daverobertson63/RoboticsChallenge/Hardware/MicroBit/documentation/Images/L298N Board.jpg

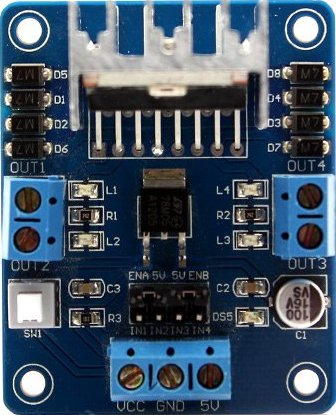
Hardware/MicroBit/documentation/Images/L298N Board.jpg
