daverobertson63/RoboticsChallenge/Hardware/MicroBit/documentation/Images/Img_0248.jpg

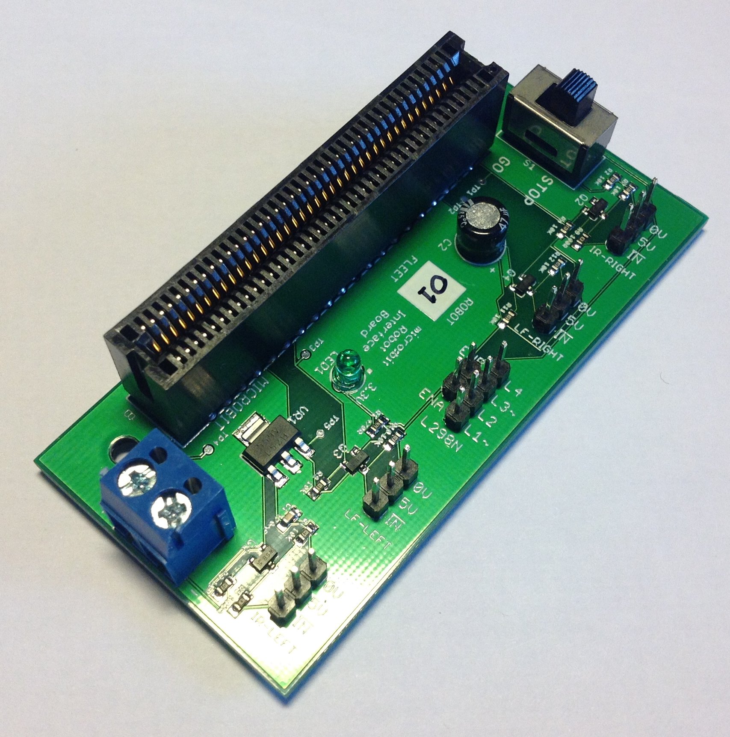
Hardware/MicroBit/documentation/Images/Img_0248.jpg
