daverobertson63/RoboticsChallenge/README.md

# RoboticsChallenge
Barclays Robotics Challenge - Main Code Repo

This is the main repo for the Barclays Remote Challenge and will work on any Unbutu style build

To install open a terminal window and make sure you are in /home/username - this is /home/roboteer

wget -N https://raw.githubusercontent.com/daverobertson63/RoboticsChallenge/master/brc.sh

chmod +x ./brc.sh

./brc.sh

Follow the instructions for either a local or remote refresh.  Local is the default one.
