daverobertson63/RoboticsChallenge/Projects/SensorProject/Sensor project.pptx

## Arduino/Pi Session

Colleague Education Series

February 2014
V1.0

Company confidential

## Build a Parking Sensor – Arduino Board

2 | Colleague Education | February 2014

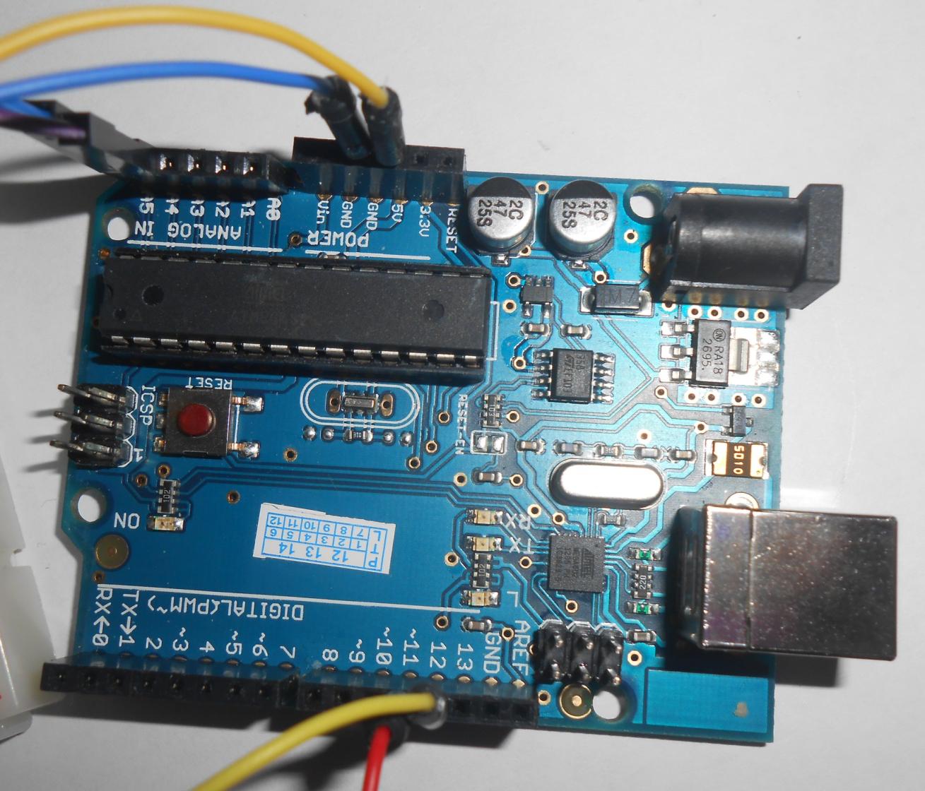
[picture p3: figure]

## Slide 3

3 | Colleague Education | February 2014

Build a Parking Sensor – Ultrasonic Sensor

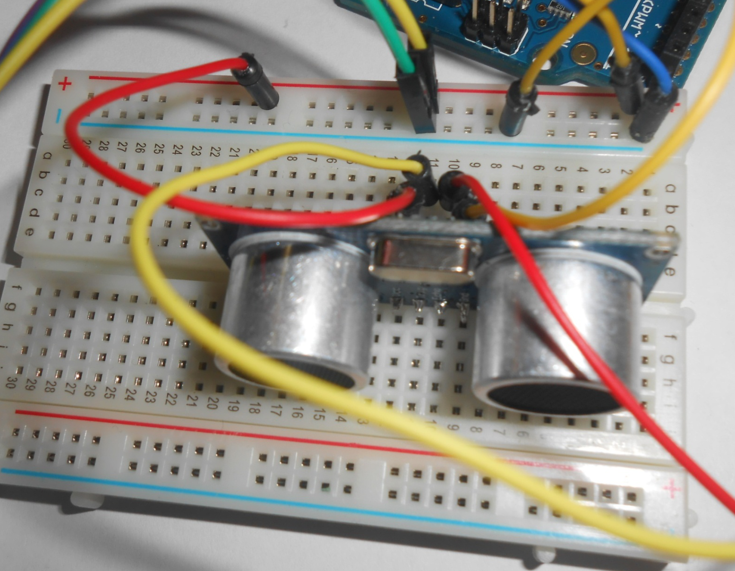
[picture p4: figure]

## Slide 4

4 | Colleague Education | February 2014

Build a Parking Sensor – LCD Screen (SainSmart)

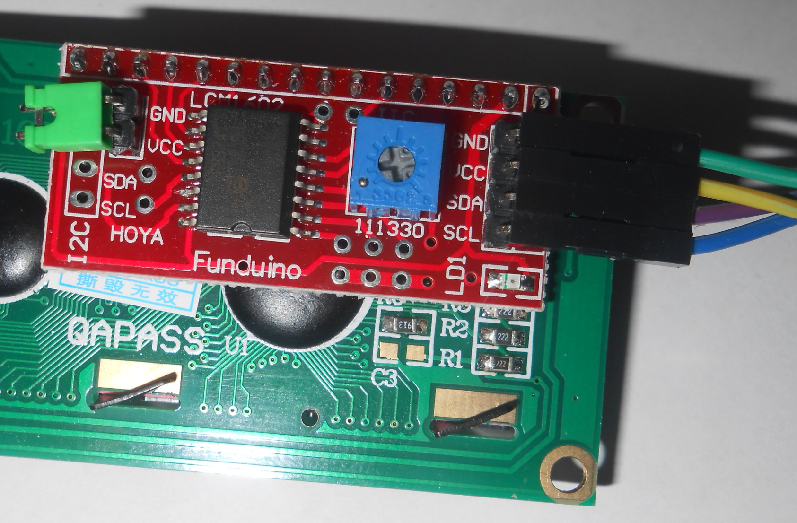
[picture p5: figure]

## Slide 5

5 | Colleague Education | February 2014

Build a Parking Sensor – LCD Screen (Digole)

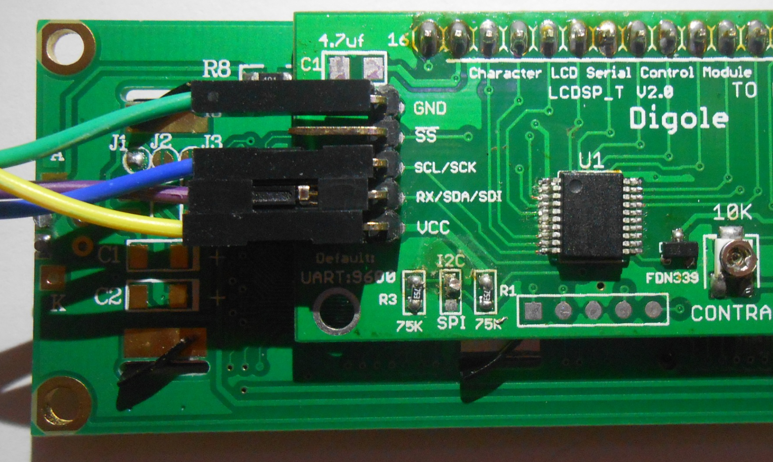
[picture p6: figure]

## Slide 6

6 | Colleague Education | February 2014

The Finished Parking Sensor

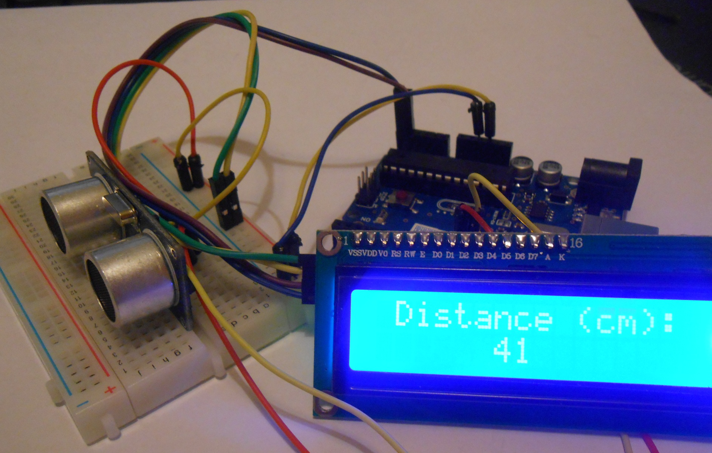
[picture p7: figure]
