daverobertson63/RoboticsChallenge/Hardware/MicroBit/documentation/Board Renders - Rev C/botcopper.png

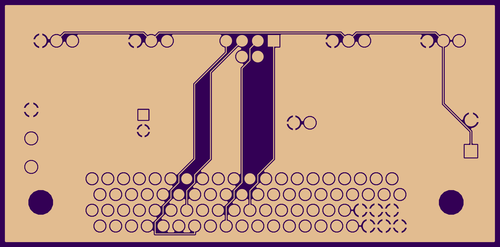
Hardware/MicroBit/documentation/Board Renders - Rev C/botcopper.png
