daverobertson63/RoboticsChallenge/Hardware/MicroBit/documentation/Board Renders - Rev C/botmask.png

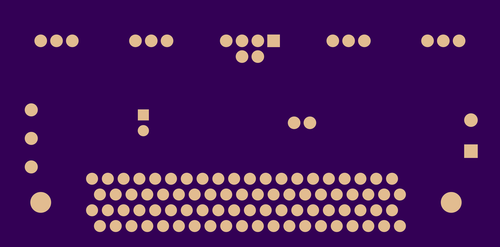
Hardware/MicroBit/documentation/Board Renders - Rev C/botmask.png
