daverobertson63/RoboticsChallenge/Hardware/MicroBit/documentation/Board Renders - Rev C/bottom.png

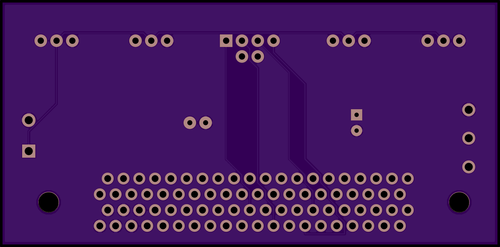
Hardware/MicroBit/documentation/Board Renders - Rev C/bottom.png
