daverobertson63/RoboticsChallenge/Hardware/MicroBit/documentation/Board Renders - Rev C/outline.png

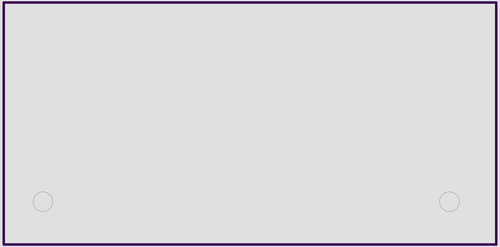
Hardware/MicroBit/documentation/Board Renders - Rev C/outline.png
