daverobertson63/RoboticsChallenge/Hardware/MicroBit/documentation/Board Renders - Rev C/top.png

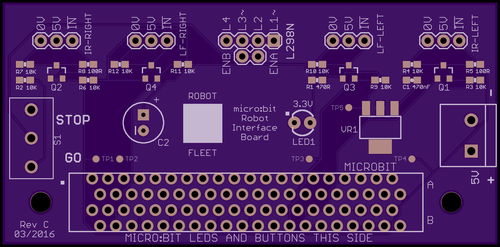
Hardware/MicroBit/documentation/Board Renders - Rev C/top.png
