daverobertson63/RoboticsChallenge/Hardware/MicroBit/documentation/Board Renders - Rev C/topcopper.png

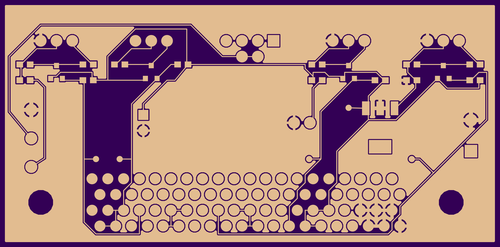
Hardware/MicroBit/documentation/Board Renders - Rev C/topcopper.png
