daverobertson63/RoboticsChallenge/Hardware/MicroBit/documentation/Board Renders - Rev C/topmask.png

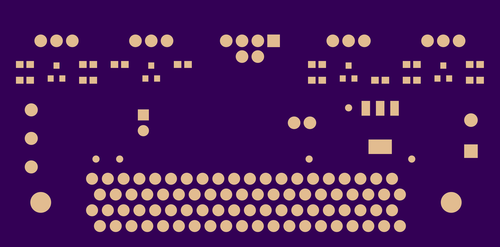
Hardware/MicroBit/documentation/Board Renders - Rev C/topmask.png
