daverobertson63/RoboticsChallenge/Hardware/MicroBit/documentation/Board Renders - Rev C/topsilk.png

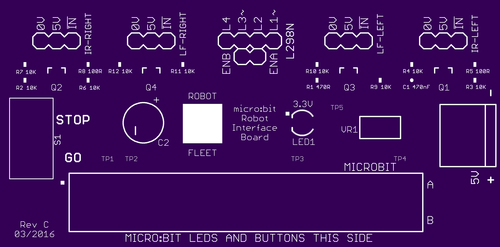
Hardware/MicroBit/documentation/Board Renders - Rev C/topsilk.png
