daverobertson63/RoboticsChallenge/Hardware/MicroBit/documentation/Images/Img_0249.jpg

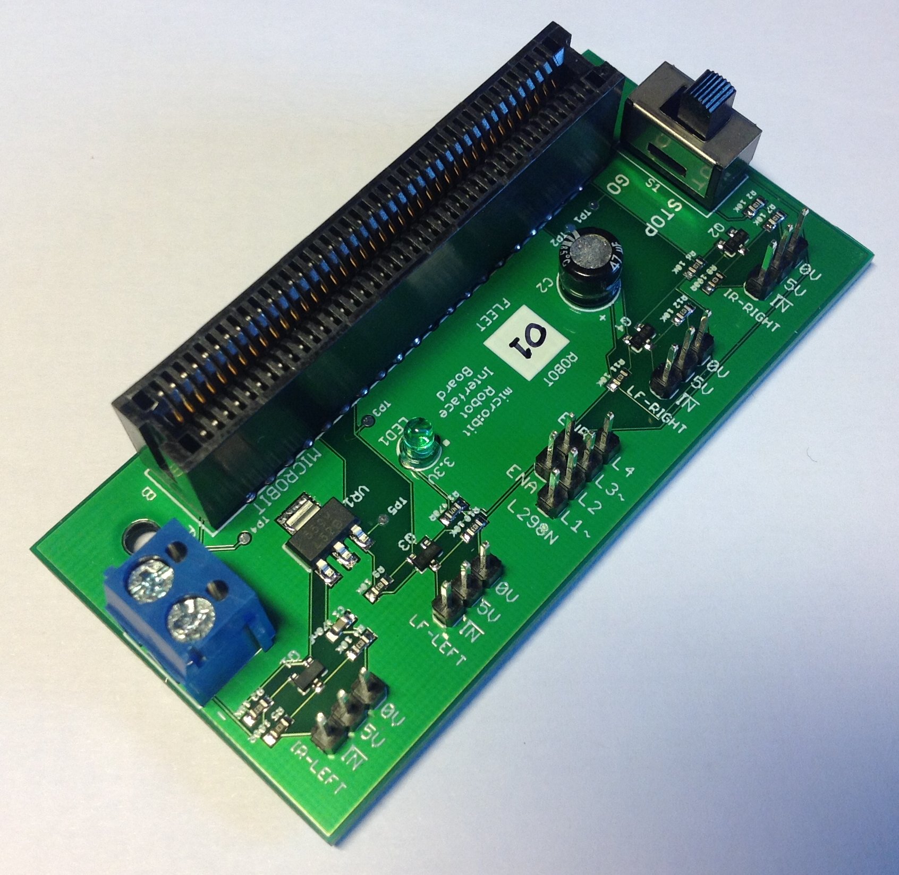
Hardware/MicroBit/documentation/Images/Img_0249.jpg
