daverobertson63/RoboticsChallenge/Hardware/MicroBit/documentation/Images/Img_0250.jpg

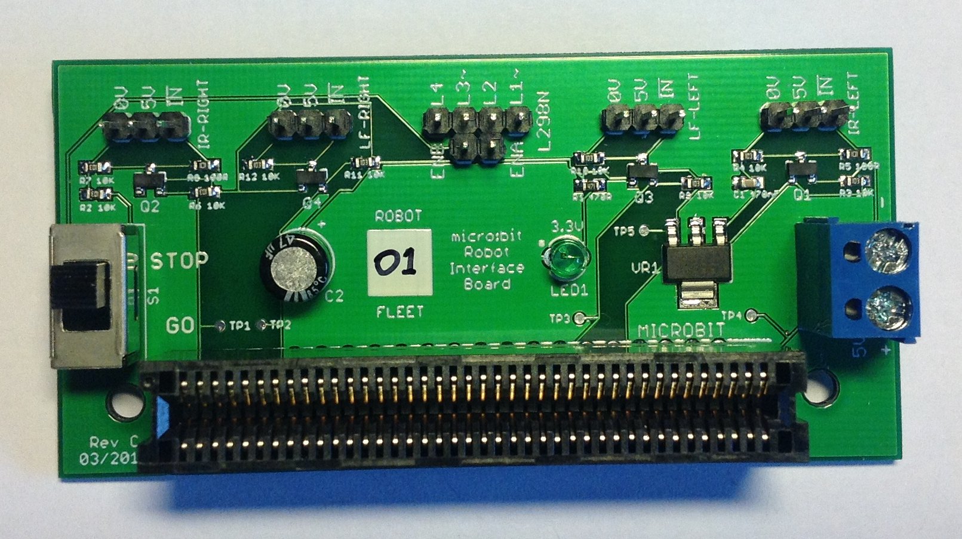
Hardware/MicroBit/documentation/Images/Img_0250.jpg
