daverobertson63/RoboticsChallenge/Hardware/MicroBit/documentation/Images/Img_0251.jpg

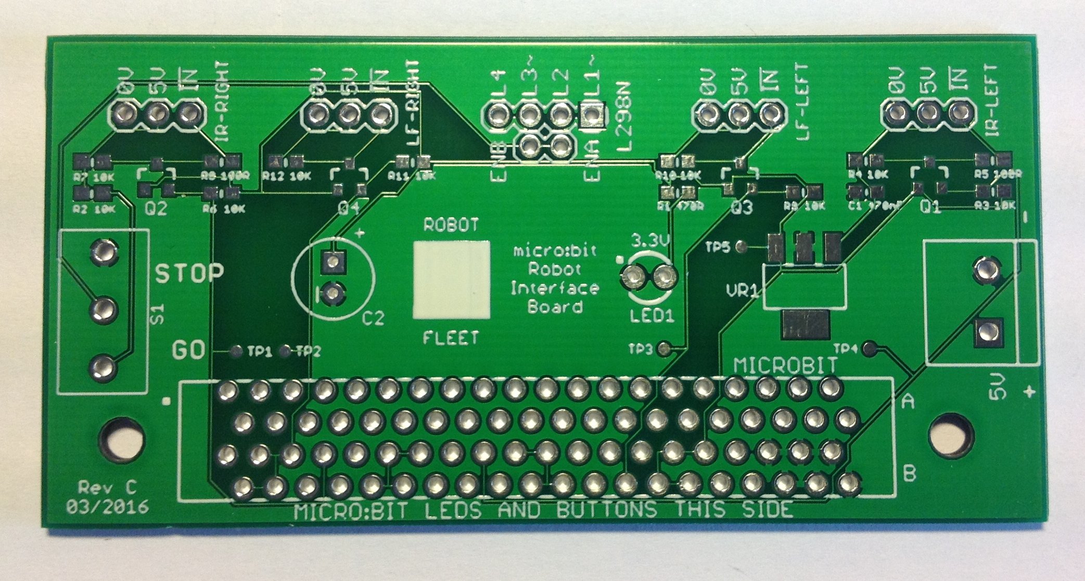
Hardware/MicroBit/documentation/Images/Img_0251.jpg
