daverobertson63/RoboticsChallenge/Hardware/MicroBit/documentation/Images/Img_0252.jpg

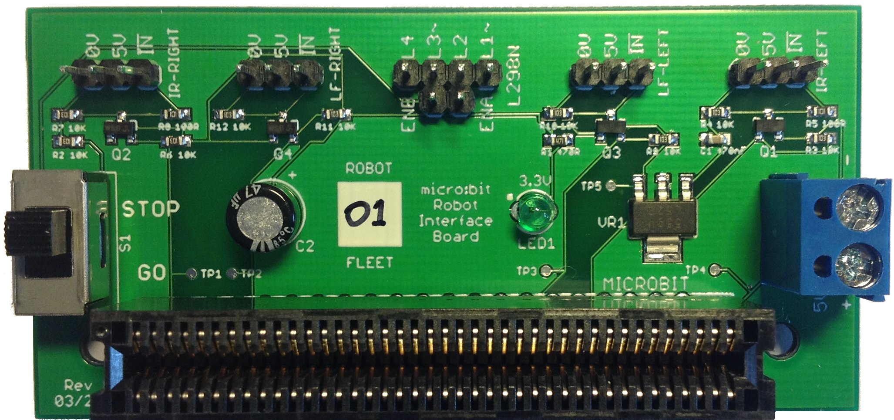
Hardware/MicroBit/documentation/Images/Img_0252.jpg
