daverobertson63/RoboticsChallenge/Hardware/MicroBit/documentation/MicroBit Robot Interface RevC - Board.pdf

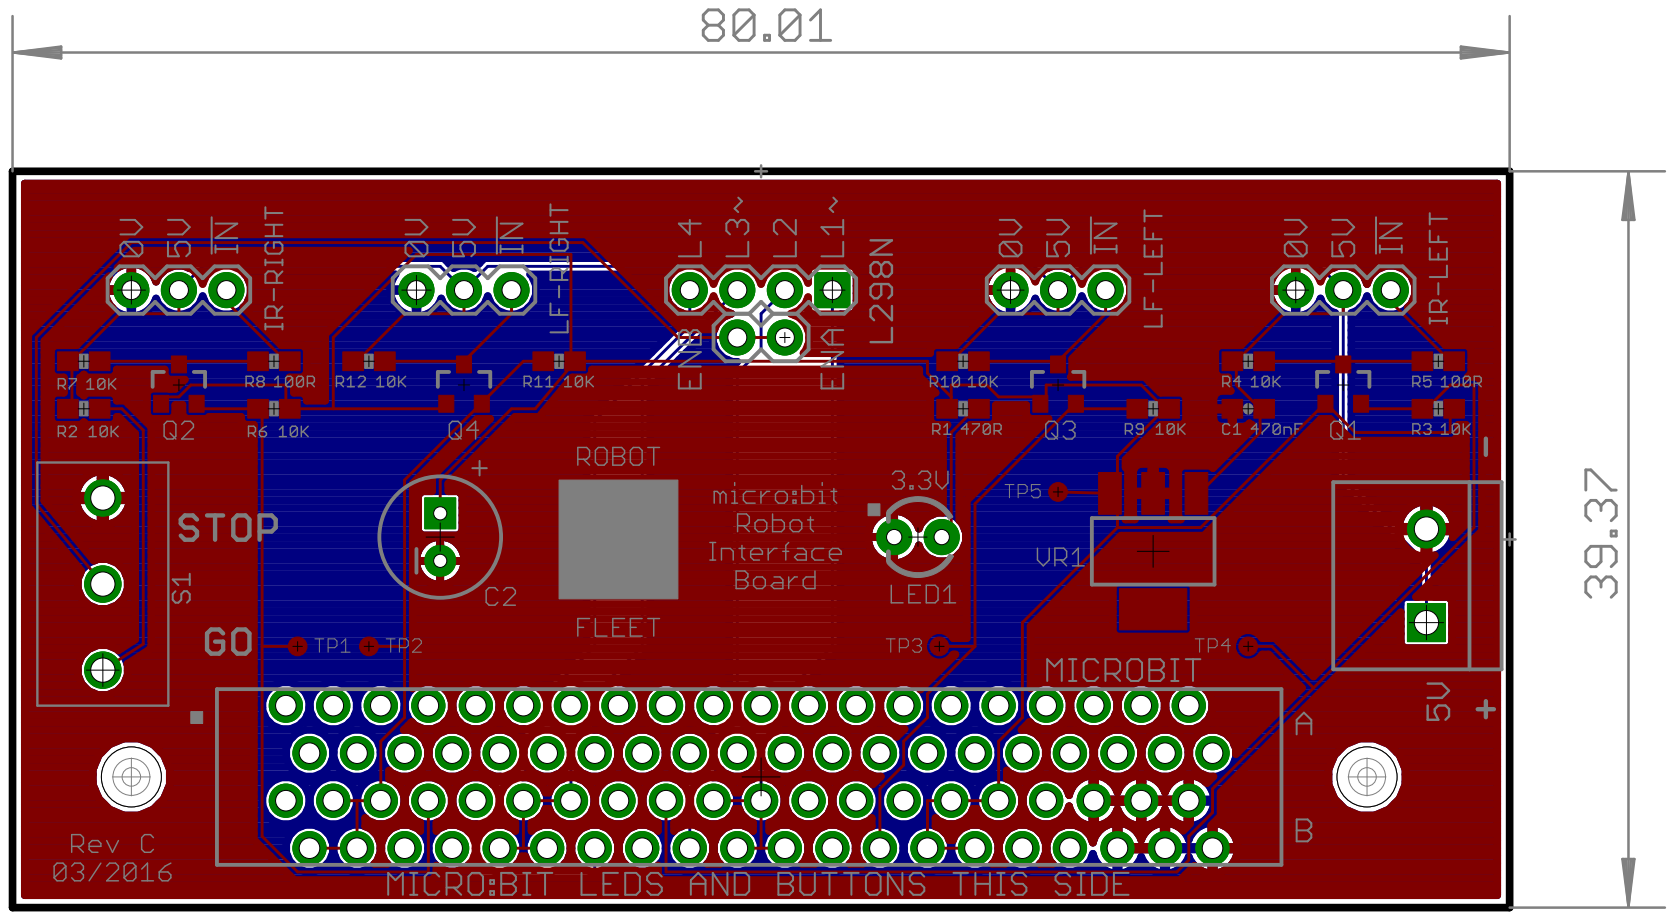
[picture p25: page 1]
