daverobertson63/RoboticsChallenge/Hardware/MicroBit/documentation/MicroBit Robot Interface RevC - Schematic.pdf

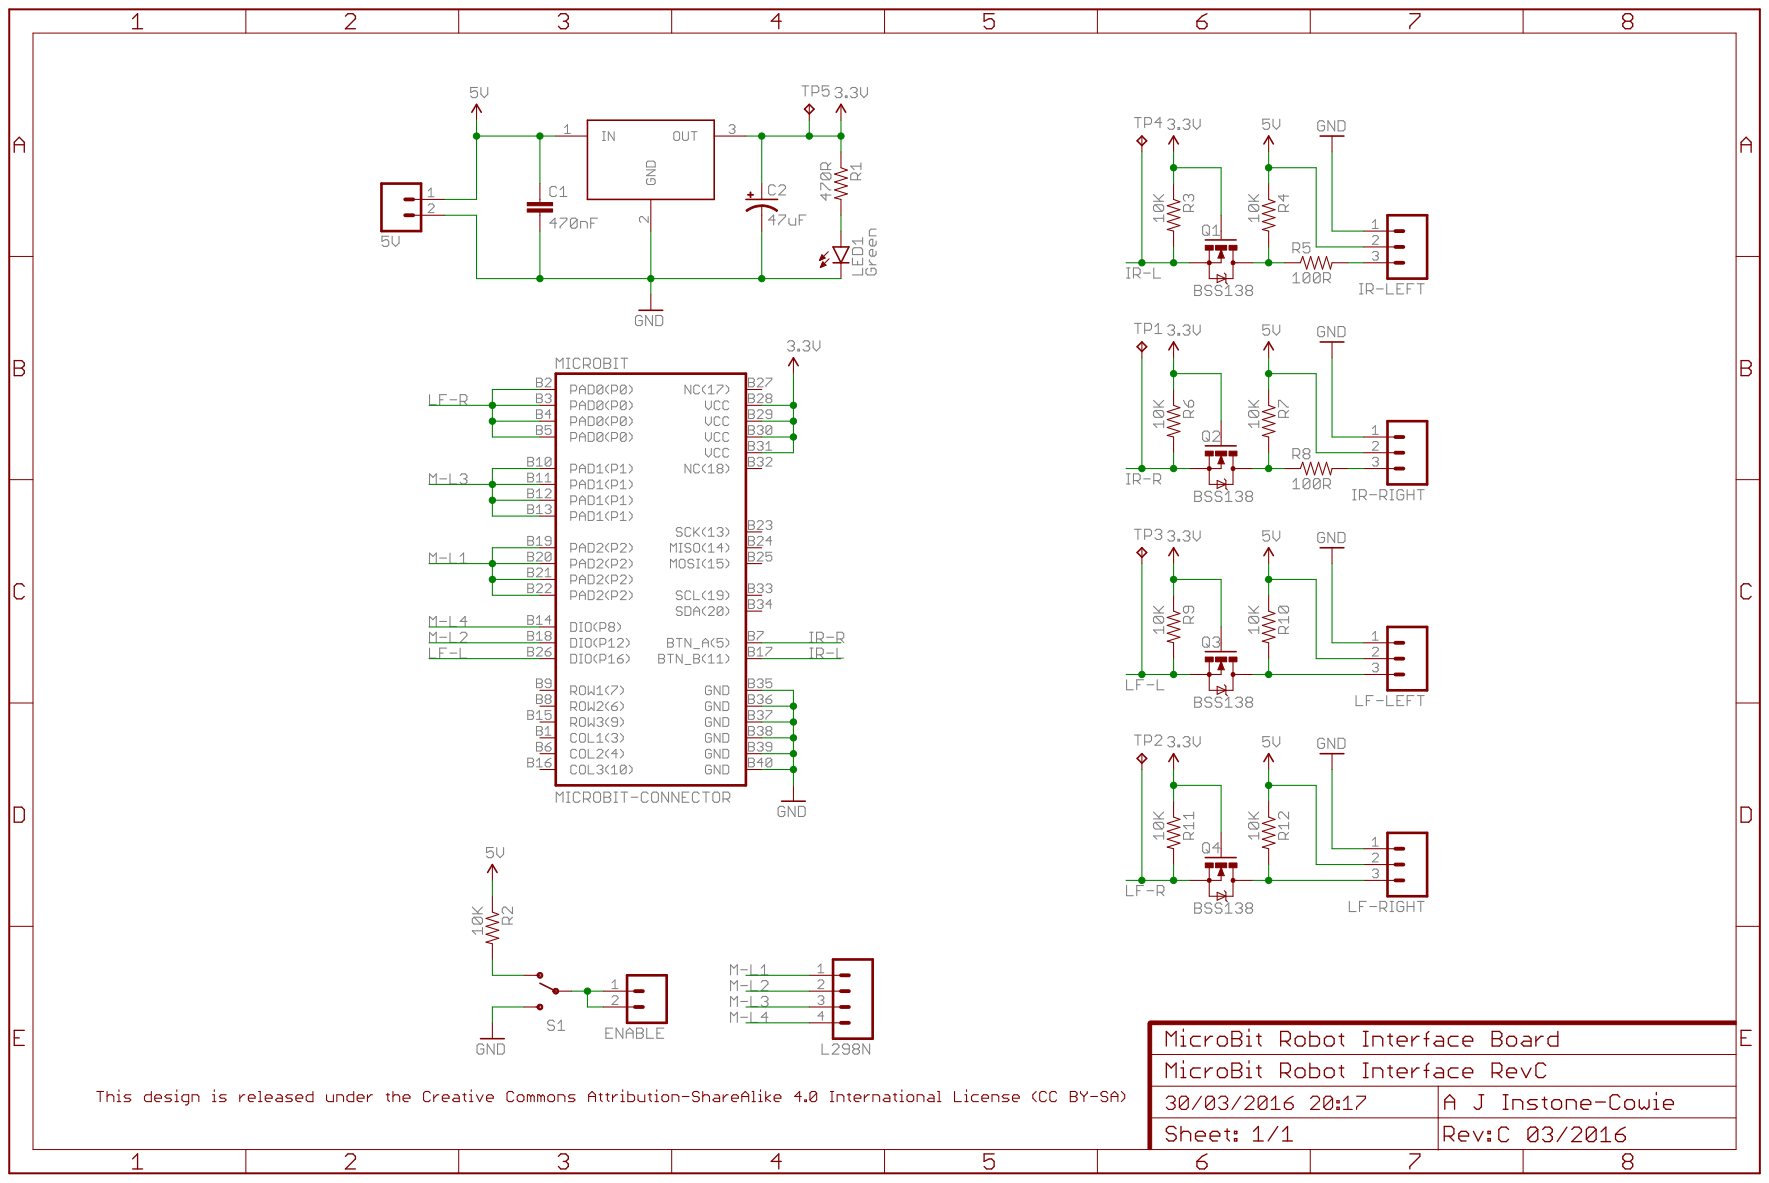
[picture p26: page 1]
