daverobertson63/RoboticsChallenge/Hardware/MicroBit/eagle/projects/MicroBit Robot Interface RevD/MicroBit Robot Interface RevD.brd

## EAGLE design Hardware/MicroBit/eagle/projects/MicroBit Robot Interface RevD/MicroBit Robot Interface RevD.brd (2016-05-15)

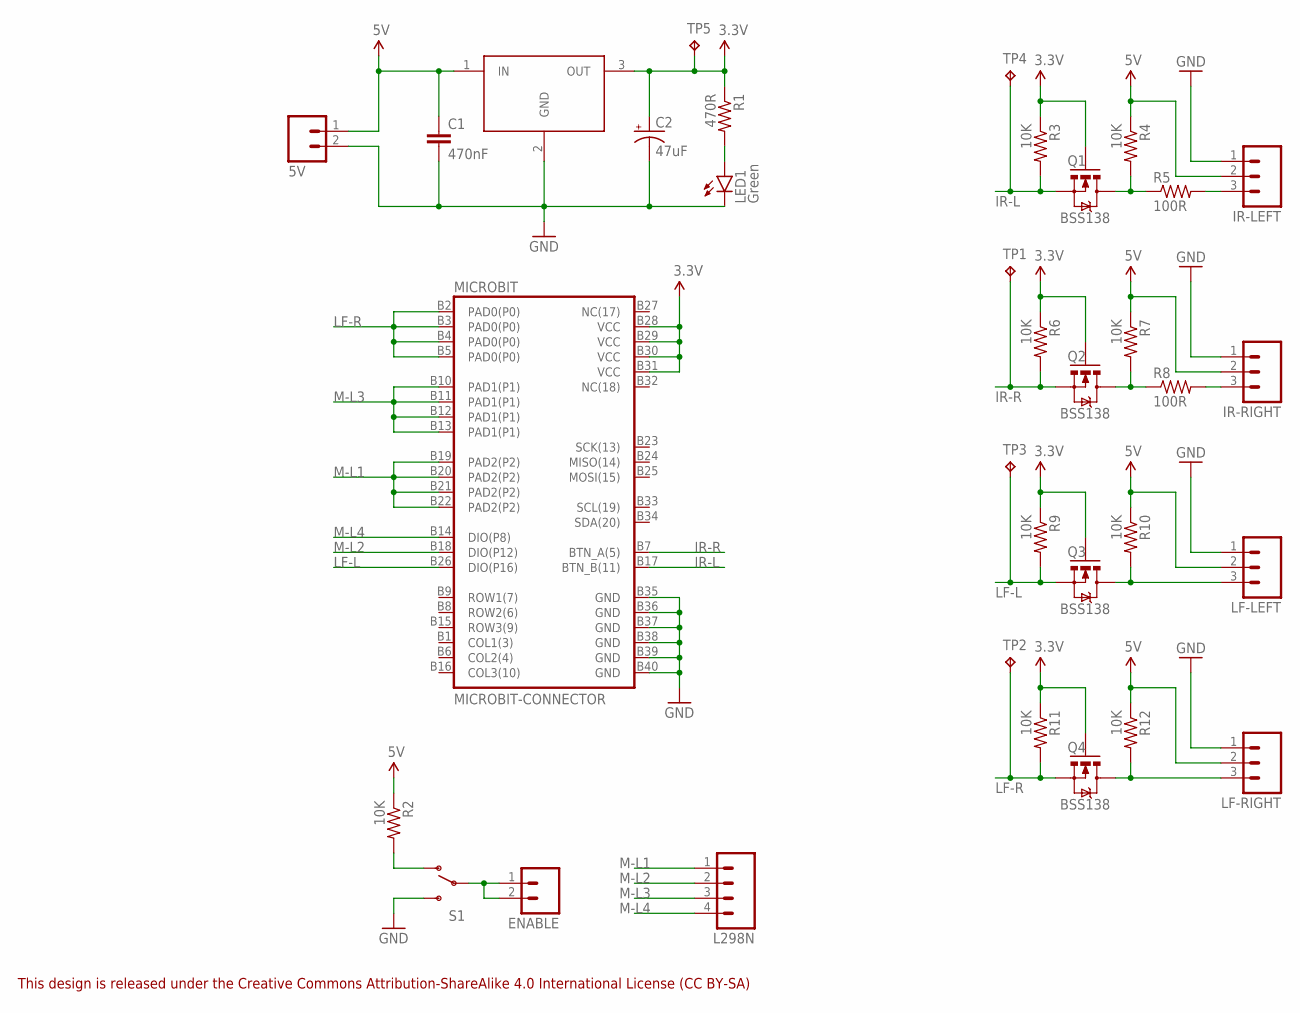
[picture p27: schematic MicroBit Robot Interface RevD.sch]

Parts:
5V: MCOMP_SCREWTERM_2PIN5MM; MCOMP-SCREWTERMINAL-5MM-2
C1: 470nF; 0603-CAP
C2: 47uF; CPOL-RADIAL-100UF-25V
ENABLE: M02PTH; 1X02
IR-LEFT: M03PTH; 1X03
IR-RIGHT: M03PTH; 1X03
L298N: M04PTH; 1X04
LED1: Green; LED3MM
LF-LEFT: M03PTH; 1X03
LF-RIGHT: M03PTH; 1X03
MICROBIT: MICROBIT-CONNECTOR; RBB40DHHN_MICROBIT
Q1, Q2, Q3, Q4: BSS138; SOT23-3
R1: 470R; 0603-RES
R2, R3, R4, R6, R7, R9, R10, R11, R12: 10K; 0603-RES
R5, R8: 100R; 0603-RES
S1: KNITTER-SWITCH-MFP106D
TP1, TP2, TP3, TP4, TP5: TPTP10R; TP10R
VR1: LM3940IMP-3.3; SOT223

Connections:
3.3V: C2.1 (+), MICROBIT.B28 (VCC), MICROBIT.B29 (VCC), MICROBIT.B30 (VCC), MICROBIT.B31 (VCC), Q1.1 (G), Q2.1 (G), Q3.1 (G), Q4.1 (G), R1.1, R3.1, R6.1, R9.1, R11.1, TP5.TP, VR1.3 (OUT)
5V: 5V.1, C1.1, IR-LEFT.2, IR-RIGHT.2, LF-LEFT.2, LF-RIGHT.2, R2.1, R4.1, R7.1, R10.1, R12.1, VR1.1 (IN)
GND: 5V.2, C1.2, C2.2 (-), IR-LEFT.1, IR-RIGHT.1, LED1.K (C), LF-LEFT.1, LF-RIGHT.1, MICROBIT.B35 (GND), MICROBIT.B36 (GND), MICROBIT.B37 (GND), MICROBIT.B38 (GND), MICROBIT.B39 (GND), MICROBIT.B40 (GND), S1.P$2 (POS2), VR1.2 (GND)
IR-L: MICROBIT.B17 (BTN_B(11)), Q1.2 (S), R3.2, TP4.TP
IR-R: MICROBIT.B7 (BTN_A(5)), Q2.2 (S), R6.2, TP1.TP
LF-L: MICROBIT.B26 (DIO(P16)), Q3.2 (S), R9.2, TP3.TP
LF-R: MICROBIT.B2 (PAD0(P0)), MICROBIT.B3 (PAD0(P0)), MICROBIT.B4 (PAD0(P0)), MICROBIT.B5 (PAD0(P0)), Q4.2 (S), R11.2, TP2.TP
M-L1: L298N.1, MICROBIT.B19 (PAD2(P2)), MICROBIT.B20 (PAD2(P2)), MICROBIT.B21 (PAD2(P2)), MICROBIT.B22 (PAD2(P2))
M-L2: L298N.2, MICROBIT.B18 (DIO(P12))
M-L3: L298N.3, MICROBIT.B10 (PAD1(P1)), MICROBIT.B11 (PAD1(P1)), MICROBIT.B12 (PAD1(P1)), MICROBIT.B13 (PAD1(P1))
M-L4: L298N.4, MICROBIT.B14 (DIO(P8))
unnamed: Q2.3 (D), R7.2, R8.1
unnamed: LF-LEFT.3, Q3.3 (D), R10.2
unnamed: LF-RIGHT.3, Q4.3 (D), R12.2
unnamed: R2.2, S1.P$1 (POS1)
unnamed: IR-LEFT.3, R5.2
unnamed: IR-RIGHT.3, R8.2
unnamed: Q1.3 (D), R4.2, R5.1
unnamed: LED1.A, R1.2
unnamed: ENABLE.1, ENABLE.2, S1.WIPER (COMMON)

Notes on the sheet:
This design is released under the Creative Commons Attribution-ShareAlike 4.0 International License (CC BY-SA)

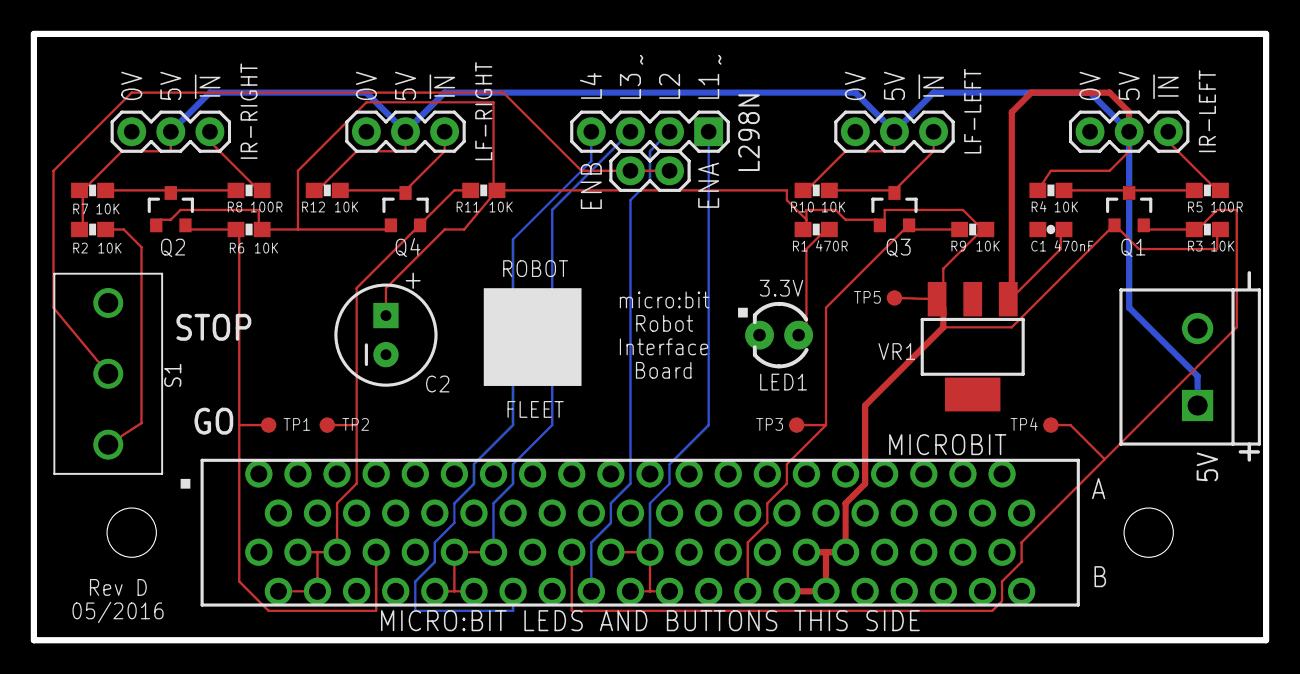
[picture p28: board MicroBit Robot Interface RevD.brd from above]

Board: 2 copper layers, 80.0 x 39.4 mm, 34 parts (0 on the bottom side), 20 nets.
