daverobertson63/RoboticsChallenge/Hardware/MicroBit/eagle/projects/TestBoard RevB/TestBoardRevB.brd

## EAGLE design Hardware/MicroBit/eagle/projects/TestBoard RevB/TestBoardRevB.brd (2016-03-14)

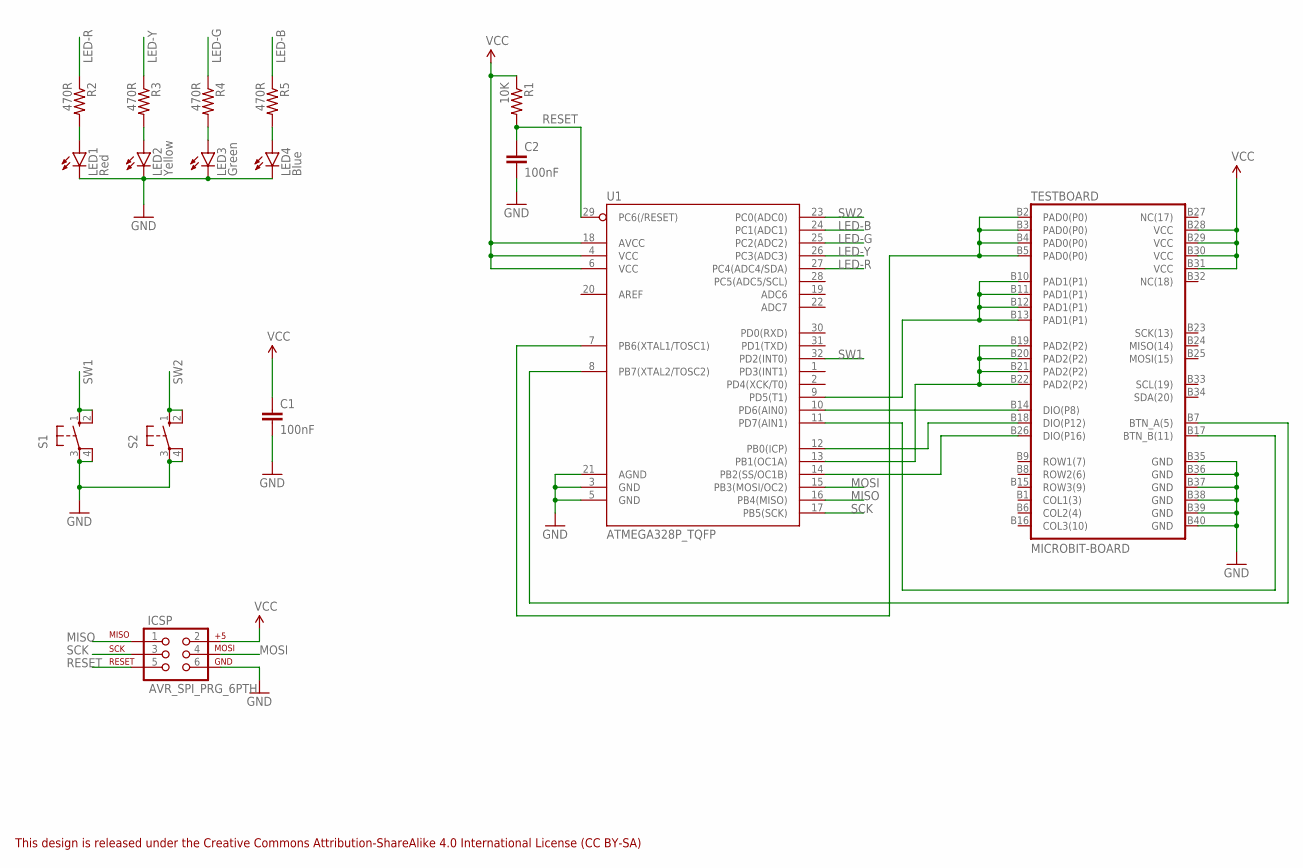
[picture p29: schematic TestBoardRevB.sch]

Parts:
C1, C2: 100nF; 0603-CAP
ICSP: AVR_SPI_PRG_6PTH; 2X3
LED1: Red; LED-0603
LED2: Yellow; LED-0603
LED3: Green; LED-0603
LED4: Blue; LED-0603
R1: 10K; 0603-RES
R2, R3, R4, R5: 470R; 0603-RES
S1, S2: 10-XX; B3F-10XX
TESTBOARD: MICROBIT-BOARD; MICROBIT-EDGE-CONN
U1: ATMEGA328P_TQFP; TQFP32-08

Connections:
GND: C1.2, C2.2, ICSP.6, LED1.C, LED2.C, LED3.C, LED4.C, S1.3, S1.4 (P1), S2.3, S2.4 (P1), TESTBOARD.B35 (GND), TESTBOARD.B36 (GND), TESTBOARD.B37 (GND), TESTBOARD.B38 (GND), TESTBOARD.B39 (GND), TESTBOARD.B40 (GND), U1.3 (GND), U1.5 (GND), U1.21 (AGND)
LED-B: R5.1, U1.24 (PC1(ADC1))
LED-G: R4.1, U1.25 (PC2(ADC2))
LED-R: R2.1, U1.27 (PC4(ADC4/SDA))
LED-Y: R3.1, U1.26 (PC3(ADC3))
MISO: ICSP.1, U1.16 (PB4(MISO))
MOSI: ICSP.4, U1.15 (PB3(MOSI/OC2))
unnamed: LED3.A, R4.2
unnamed: TESTBOARD.B2 (PAD0(P0)), TESTBOARD.B3 (PAD0(P0)), TESTBOARD.B4 (PAD0(P0)), TESTBOARD.B5 (PAD0(P0)), U1.7 (PB6(XTAL1/TOSC1))
unnamed: TESTBOARD.B7 (BTN_A(5)), U1.8 (PB7(XTAL2/TOSC2))
unnamed: TESTBOARD.B19 (PAD2(P2)), TESTBOARD.B20 (PAD2(P2)), TESTBOARD.B21 (PAD2(P2)), TESTBOARD.B22 (PAD2(P2)), U1.13 (PB1(OC1A))
unnamed: LED4.A, R5.2
unnamed: TESTBOARD.B10 (PAD1(P1)), TESTBOARD.B11 (PAD1(P1)), TESTBOARD.B12 (PAD1(P1)), TESTBOARD.B13 (PAD1(P1)), U1.9 (PD5(T1))
unnamed: LED1.A, R2.2
unnamed: TESTBOARD.B14 (DIO(P8)), U1.10 (PD6(AIN0))
unnamed: TESTBOARD.B18 (DIO(P12)), U1.12 (PB0(ICP))
unnamed: TESTBOARD.B26 (DIO(P16)), U1.14 (PB2(SS/OC1B))
unnamed: TESTBOARD.B17 (BTN_B(11)), U1.11 (PD7(AIN1))
unnamed: LED2.A, R3.2
RESET: C2.1, ICSP.5, R1.2, U1.29 (PC6(/RESET))
SCK: ICSP.3, U1.17 (PB5(SCK))
SW1: S1.1 (S), S1.2 (S1), U1.32 (PD2(INT0))
SW2: S2.1 (S), S2.2 (S1), U1.23 (PC0(ADC0))
VCC: C1.1, ICSP.2, R1.1, TESTBOARD.B28 (VCC), TESTBOARD.B29 (VCC), TESTBOARD.B30 (VCC), TESTBOARD.B31 (VCC), U1.4 (VCC), U1.6 (VCC), U1.18 (AVCC)

Notes on the sheet:
This design is released under the Creative Commons Attribution-ShareAlike 4.0 International License (CC BY-SA)

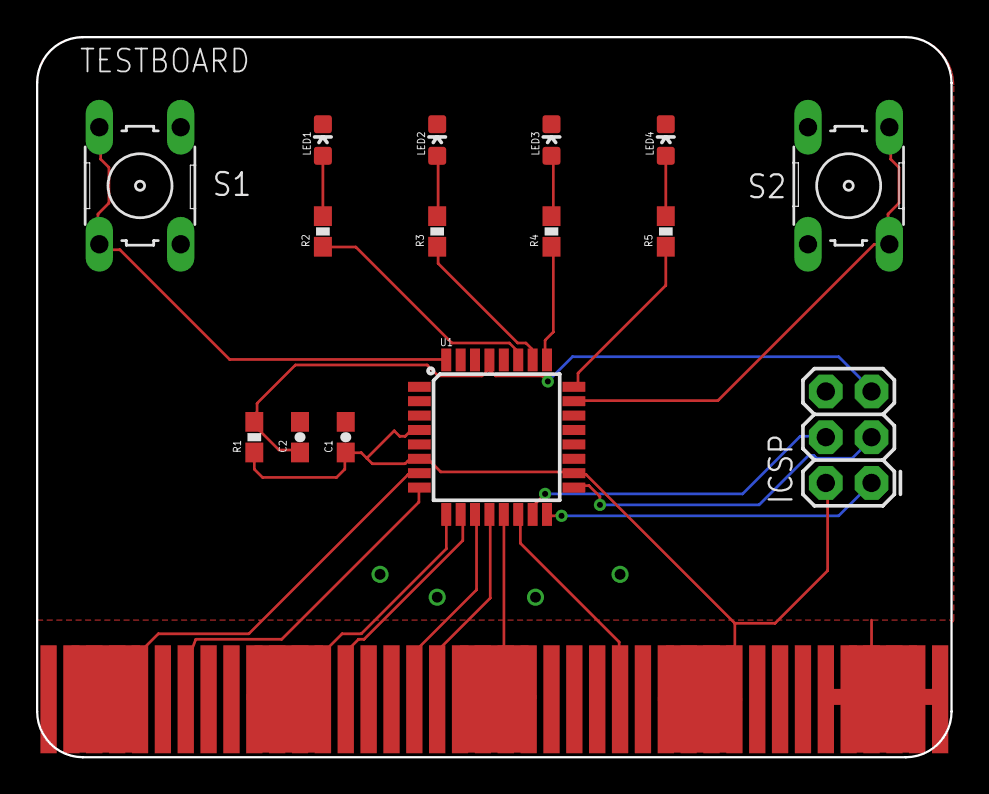
[picture p30: board TestBoardRevB.brd from above]

Board: 2 copper layers, 50.8 x 40.0 mm, 16 parts (0 on the bottom side), 24 nets.
