daverobertson63/RoboticsChallenge/Hardware/Arduino/eagle/projects/Arduino Robot Interface Shield RevB/RobotShieldInterfaceRevB.brd

## EAGLE design Hardware/Arduino/eagle/projects/Arduino Robot Interface Shield RevB/RobotShieldInterfaceRevB.brd (2016-03-30)

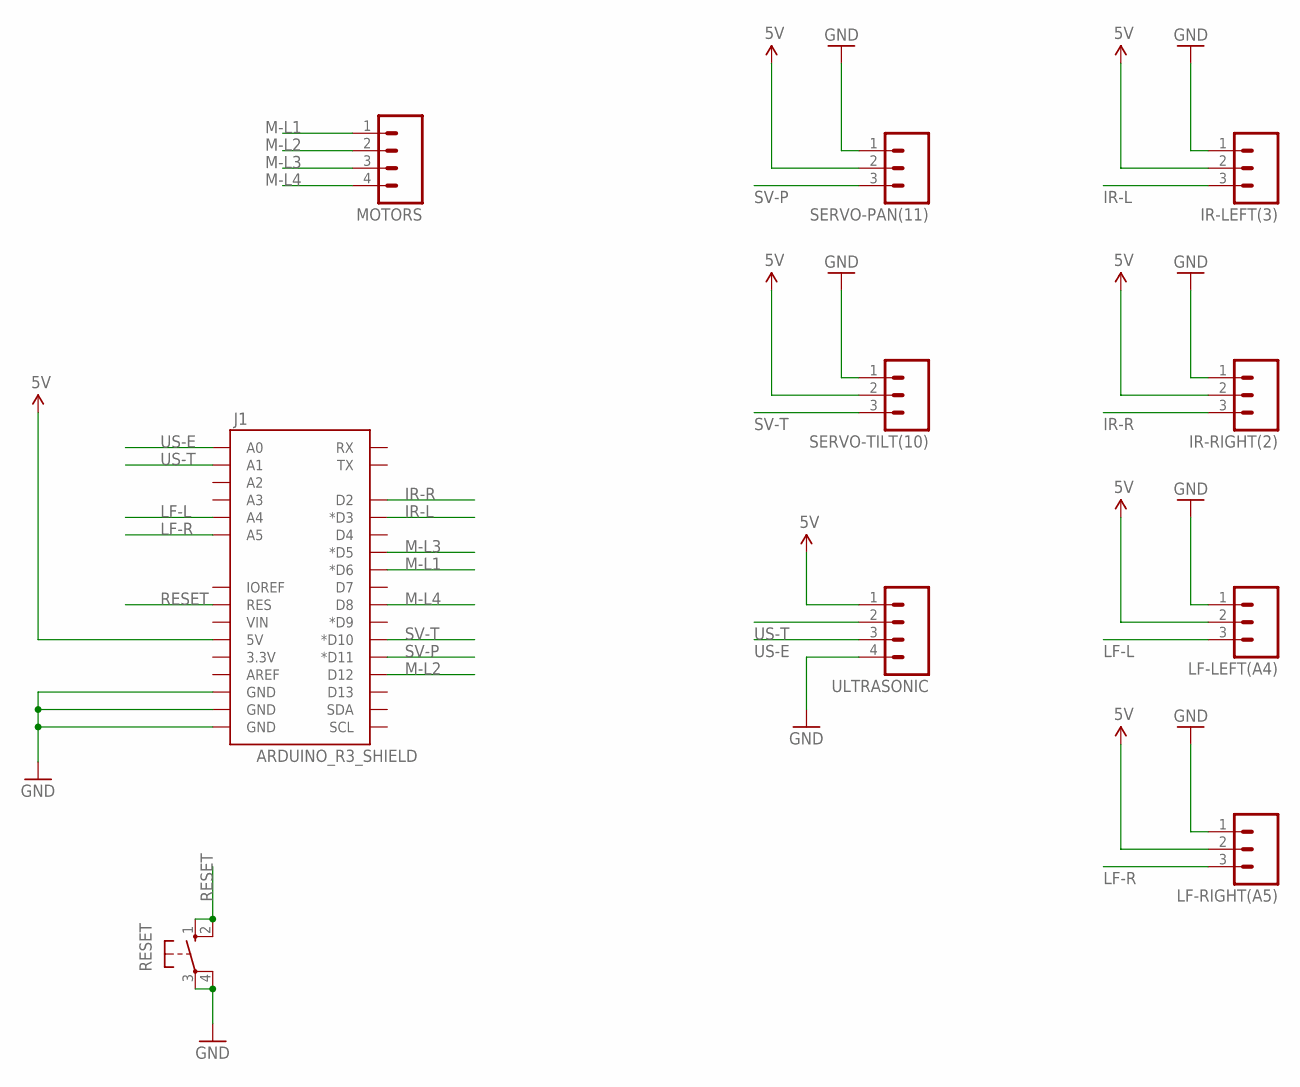
[picture p31: schematic RobotShieldInterfaceRevB.sch]

Parts:
IR-LEFT(3): M03PTH; 1X03
IR-RIGHT(2): M03PTH; 1X03
J1: ARDUINO_R3_SHIELD; UNO_R3_SHIELD
LF-LEFT(A4): M03PTH; 1X03
LF-RIGHT(A5): M03PTH; 1X03
MOTORS: M04PTH; 1X04
RESET: 10-XX; B3F-10XX
SERVO-PAN(11): M03PTH; 1X03
SERVO-TILT(10): M03PTH; 1X03
ULTRASONIC: M04PTH; 1X04

Connections:
5V: IR-LEFT(3).2, IR-RIGHT(2).2, J1.5V, LF-LEFT(A4).2, LF-RIGHT(A5).2, SERVO-PAN(11).2, SERVO-TILT(10).2, ULTRASONIC.1
GND: IR-LEFT(3).1, IR-RIGHT(2).1, J1.GND@0 (GND), J1.GND@1 (GND), J1.GND@2 (GND), LF-LEFT(A4).1, LF-RIGHT(A5).1, RESET.3, RESET.4 (P1), SERVO-PAN(11).1, SERVO-TILT(10).1, ULTRASONIC.4
IR-L: IR-LEFT(3).3, J1.D3 (*D3)
IR-R: IR-RIGHT(2).3, J1.D2
LF-L: J1.A4, LF-LEFT(A4).3
LF-R: J1.A5, LF-RIGHT(A5).3
M-L1: J1.D6 (*D6), MOTORS.1
M-L2: J1.D12, MOTORS.2
M-L3: J1.D5 (*D5), MOTORS.3
M-L4: J1.D8, MOTORS.4
RESET: J1.RES, RESET.1 (S), RESET.2 (S1)
SV-P: J1.D11 (*D11), SERVO-PAN(11).3
SV-T: J1.D10 (*D10), SERVO-TILT(10).3
US-E: J1.A0, ULTRASONIC.3
US-T: J1.A1, ULTRASONIC.2

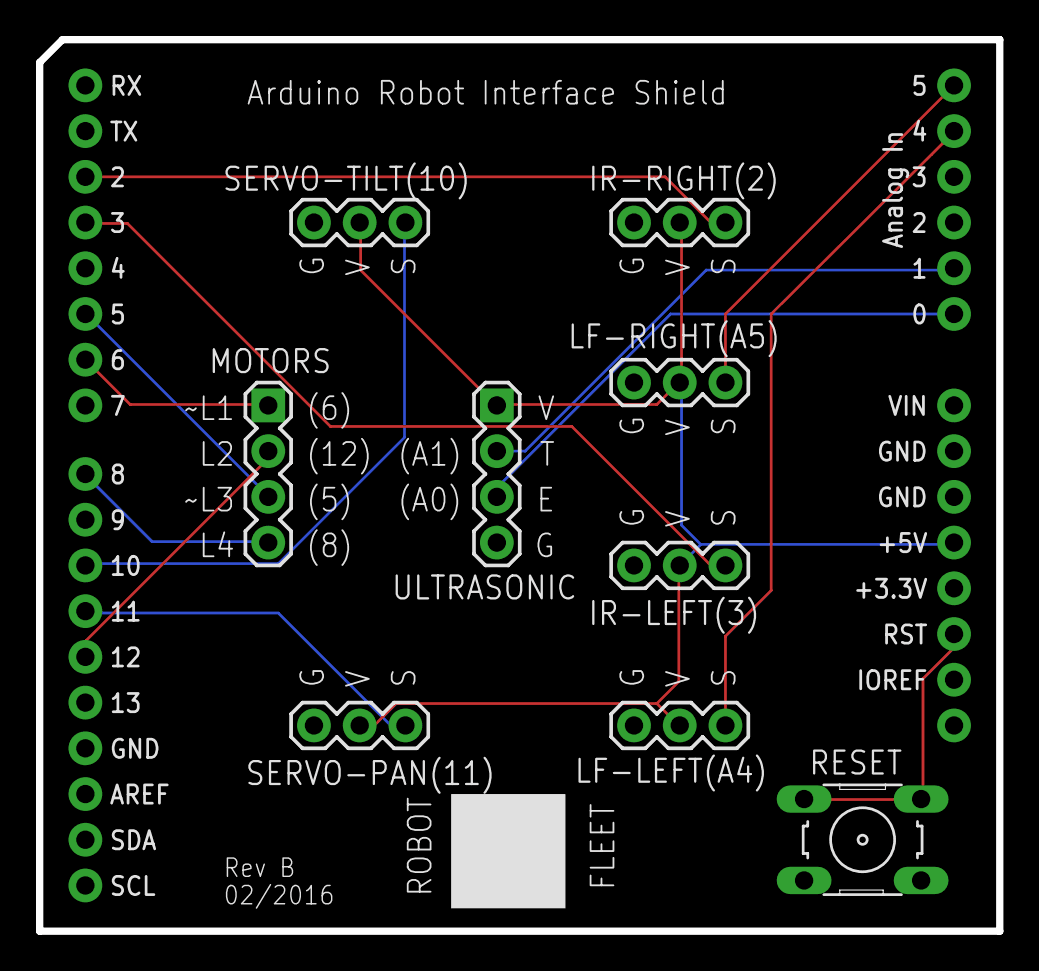
[picture p32: board RobotShieldInterfaceRevB.brd from above]

Board: 2 copper layers, 53.3 x 49.5 mm, 10 parts (0 on the bottom side), 15 nets.
