daverobertson63/RoboticsChallenge/Projects/Solutions/RobotLines/RobotLines (Dave Robertson's conflicted copy 2014-03-15).ino

/*

  V 0.1 - 12/09/13
  
  This is the MasterSketch template for the 
  Robotics Challenge - Only contains the functions and the
  Basic movement

  
  Moves the car forwards, backwards, right rotate, left rotate, halt.
  Speed control can be used to test
  
  Also has a TestAll function you use to test all components are working

*/

// New ping stuff - wont need library as the CPP is included in sketch

#include <NewPing.h>
#include <Servo.h> // need the standard Arduino servo library

#define TRIGGER_PIN  A1  // Arduino pin tied to trigger pin on the ultrasonic sensor.
#define ECHO_PIN     A0  // Arduino pin tied to echo pin on the ultrasonic sensor.
#define MAX_DISTANCE 200 // Maximum distance we want to ping for (in centimeters). Maximum sensor distance is rated at 400-500cm.
int cm;                  // Approximate distance

int lDetect = 3, rDetect = 2;             // Pins for obstacle sensors (remove rDetect connection when downloading sketch to Arduino)

#define SENSORON true
#define SENSOROFF false

boolean leftObstacleSensor();
boolean rightObstacleSensor();

// Set up the values for the sensors
boolean leftSensor=false;
boolean rightSensor=false;

NewPing sonar(TRIGGER_PIN, ECHO_PIN, MAX_DISTANCE); // NewPing setup of pins and maximum distance.

// Pan and tilt stuff
int panPin = 11;  // this is Servo used for panning (horizontal plane movement)
int tiltPin = 10; // This is Servo used for tilting (vertical plane movement)
Servo panServo, tiltServo;
int panCentre = 90;
int servoMax=180;
int servoMin=0;

// These variables are used by the readsensors
int Ref=100;
int SampleSize=10;
int Left,Right;

// You can use this variable to say which was the last lost side which can help if you get a double sensor pn white
// The idea is that if the line turns to the left and you get two white readings - then the idea is to know
// the direction of the last lost sensor.  Look in the linefollowr coded for the lastlot variable to see how it works

int lastLost=0;  

// If you have new sensors you may need to switch these 
#define BLACK 0
#define WHITE 1


// Map the Pin Numbers to the motor controller - PLEASE NOTE L3 MOVES to 12
int L1 = 6, L2 = 5, L3 = 12, L4 =8;

// the setup routine runs once when you press reset:
// This must be here to set your pins for the motor
void setup()
{                
  // initialize the digital pins we will use as an output for the Motors
  pinMode(L1, OUTPUT);     
  pinMode(L2, OUTPUT);     
  pinMode(L3, OUTPUT);     
  pinMode(L4, OUTPUT);
  
  // Just make sure the Obstacle sensors are ok.
  pinMode (lDetect, INPUT);
  pinMode (rDetect, INPUT);

  // Pan and Tilt setup
  panServo.attach(panPin, 1000, 2000);
  tiltServo.attach(tiltPin, 1000, 2000);
  pointCentre();
  tiltCentre();
  
    Serial.begin(115200);  // Start the Serial and make sure the debug says 115200 
  
  // ROBOTEERS - this will be your first action - ucomment to test the robot functions
  // Uncomment the line and use the DEBUG icon top right og the Arduino Window
  // Make sure its set to 115200 please otherwise you get gobbledegook
  
  //while(1)  // Use this to repeat forever
  // testAll();

}

//
// the loop routine runs over and over again forever:
// 


void loop()
{
  
  readSensors();
  
  //delay(500);
    
  //return;
  if (Left == BLACK && Right == BLACK ){      // Both sensors detect white surface so just run and run!
  
     
     forward(100,200);              // Move and srtop
     halt(100);
     

  }
  else if (Left == WHITE  && Right == BLACK) {             // Left sensor detects black line
  
       
      halt(50);
     rightSpin(100,255);
     lastLost=1;
     return;
     
  }
  else if (Right == WHITE && Left == BLACK){             // Right sensor detects black line
  
     halt(50);
     leftSpin(100,255);
     lastLost=-1;
     return;
  }
  
  else if (Right == WHITE && Left == WHITE ){             // Right sensor detects black line
  
     halt(50);
     reverse(50,255);
     
     //findLine();
     
     return;
  
  }
  
}
  
    

// This is a function called findLine - it tries to find the line and get the 
// robot back onto the line

void findLine()

{
  int found=0;
  int count=0;
  int dir=1;
  
  // The last direction is stored so that we go the other way next time
  if ( lastLost == 1 ) 
    dir=1;
  else
    dir=-1;
  
  while(!found)
  {
    delay(500);
    readSensors();
    
    if (Left == BLACK && Right == BLACK ){      // Both sensors detect white surface
    
       // Add a couple of extra ones here
       if ( dir == 1 )
       {
         rightSpin(100,150);
         rightSpin(100,150);
       }
      else
      {
        leftSpin(100,150);
        leftSpin(100,150);
        
      }

        Serial.println("Found Line!");
       return;
    }
    
    Serial.print("Lost: ");
    Serial.print(dir);
    Serial.print("Count: ");
    Serial.println(count);

    if ( dir == 1 )  
      rightSpin(100,150);
    else
       leftSpin(100,150);


     count = count+dir;
      
     if ( count > 5   ) {
        
        dir=-dir;
        count=0;
     }
     
     // we have done the full sweep so go back a bit and try again
     if (count< -5){
        dir=-dir;
        count=0;
        reverse(100,150); // go back
     }
    
     Serial.println("I am Seeking The Line");
   
  }
  
  
}



// Dont add code below here


// robMove routine switches the correct inputs to the L298N for the direction selected.
void robMove(int l1, int l2, int r1, int r2)
{
  analogWrite(L1, l1);
  digitalWrite(L2, l2);
  analogWrite(L3, r1);
  digitalWrite(L4, r2);  
}

void reverse(int wait, int vSpeed)
{
  Serial.println("Moving backward: " + String(vSpeed));
  robMove(255-vSpeed, HIGH, 255-vSpeed, HIGH);    // when reversing, the speed needs to be opposite, so subtract from 255
  delay(wait);
}

void forward(int wait, int vSpeed)
{
  Serial.println("Moving forward: " + String(vSpeed));
  robMove(vSpeed, LOW, vSpeed, LOW);
  delay(wait);
}

void rightSpin(int wait, int vSpeed)
{
  Serial.println("Spinning right");
  robMove(vSpeed, LOW, 0, HIGH);
  delay(wait);
  robMove(0, LOW, 0, LOW);
}

void leftSpin(int wait,int vSpeed)
{
  Serial.println("Spinning left");
  robMove(0, HIGH, vSpeed, LOW);
  delay(wait);
  robMove(0, LOW, 0, LOW);
}

void rightTurnFd(int wait, int lSpeed, int rSpeed)
{
  Serial.println("Turning right forward");
  robMove(lSpeed, LOW, rSpeed, LOW);
  delay(wait);
}

void leftTurnFd(int wait, int lSpeed, int rSpeed)
{
  Serial.println("Turning left forward");
  robMove(lSpeed, LOW, rSpeed, LOW);
  delay(wait);
}

void rightTurnBd(int wait, int lSpeed, int rSpeed)
{
  Serial.println("Turning right backward");
  robMove(255-lSpeed, HIGH, 255-rSpeed, HIGH);
  delay(wait);
}

void leftTurnBd(int wait, int lSpeed, int rSpeed)
{
  Serial.println("Turning left backward");
  robMove(255-lSpeed, HIGH, 255-rSpeed, HIGH);
  delay(wait);
}

void halt(int wait)
{
  Serial.println("Stopping");
  robMove(0, LOW, 0, LOW);
  delay(wait);
}

// Sensors Functions

void readSensors()
{
 
 
  leftObstacleSensor();
  rightObstacleSensor();
  Ultrasonic();
  delay(0);
  Left=0;
  Right=0;
  
  for ( int i=0;i<SampleSize;i++)
  {
    Left  += analogRead(A4);           // Read value from left sensor
    Right += analogRead(A5);           // Read value from right sensor
    //Serial.println(Left);
    //Serial.println(Right);
  
   
    
  }
   //Serial.println(Left);
   //Serial.println(Right);
  Left = Left/SampleSize;
  Right = Right/SampleSize;
   //Serial.println(Left);
   //Serial.println(Right);
  
   if ( Left < Ref )
      Left = BLACK;
    if ( Left > Ref )
      Left = WHITE;
    
    if ( Right < Ref )
      Right = BLACK;
    if ( Right > Ref )
      Right = WHITE;
  
 //  Serial.println(Left);
 //  Serial.println(Right);
  
}

boolean leftObstacleSensor()
{
 
  //Serial.println(digitalRead(lDetect));
  if (digitalRead(lDetect)==0) // Test left sensor
  {
    Serial.println("Left IR Detected");
    leftSensor=true;
    return true;
  }
  leftSensor=false;
  return false;
}

boolean rightObstacleSensor()
{
 
  //Serial.println(digitalRead(rDetect));
  if (digitalRead(rDetect)==0) // Test left sensor
  {
    Serial.println("Right IR Detected");
    leftSensor=true;
    return true;
  }
  leftSensor=false;
  return false;

}


int Ultrasonic()
{
 
   delay(50);                      // Wait 50ms between pings (about 20 pings/sec). 29ms should be the shortest delay between pings.
  
  unsigned int uS = sonar.ping(); // Send ping, get ping time in microseconds (uS).
  //Serial.print("Ping: ");
  
  
  cm=uS / US_ROUNDTRIP_CM;
  
  if ( cm == 0 ) 
    cm = 1000;  // Clear!

  //Serial.print(cm);
  //Serial.println("cm");
  
  return cm;
}


void pointLeft()
{
  panServo.write(servoMax);

  Serial.println("Point Left");

  delay(150); // wait for servo to get there
}

void pointRight()
{
    Serial.println("Point Right");
  panServo.write(servoMin);
  delay(300); // wait for servo to get there
}

void pointCentre()
{
  Serial.println("Point Centre");
  panServo.write(panCentre);
  delay(150); // wait for servo to get there
}

void pointValue(int pos)
{
  Serial.print("Point Value: ");
  Serial.println(pos);
  panServo.write(pos);
  delay(150); // wait for servo to get there
}


void tiltUp()
{
  Serial.println("Tilt Up");
  tiltServo.write(servoMin);
  delay(150); // wait for servo to get there
}

void tiltDown()
{
  Serial.println("Tilt Down");
  tiltServo.write(servoMax);
  delay(300); // wait for servo to get there
}

void tiltCentre()
{
  Serial.println("Tilt Centre");
  tiltServo.write(panCentre);
  delay(150); // wait for servo to get there
}

void tiltCentre(int pos)
{
  Serial.print("Tilt Value: ");
  Serial.println(pos);
  tiltServo.write(pos);
  delay(150); // wait for servo to get there
}

void testAll()
{
long startTime;  // Captures starttime in clock time - time is milieocns between them
long endTime;
  
  // ROBOTEERS this is the test all funcion - it will execute this once soit needs to be called from loop
  // 
  
  // Can change the value here for speed - 0 -> 255
  //  parameter is delay in ms after performing operation
  
  readSensors();  // Best to keep this here
  
  // Basic code - just remove this or add commenrts 
  
  Serial.println("TESTING MOVEMENT SHOULD TAKE ABOUT 10 seconds");
  Serial.println("FULL POWER 255");
  forward(1000,255);
  halt(1000);
  
  reverse(1000,255);
  halt(1000);
  
  leftSpin(1000,255);
  halt(1000);
  
  rightSpin(1000,255);
  halt(1000);
 
  Serial.println("HALF POWER 180");
  forward(1000,180);
  halt(1000);
  
  reverse(1000,180);
  halt(1000);
  
  leftSpin(1000,180);
  halt(1000);
  
  rightSpin(1000,180);
  halt(1000);
 
  
 Serial.println("NOW TESTING PAN AND TILT 5 TIMES");
 Serial.println("TESTING PAN 5 TIMES - PLEASE ENSURE THIS IS A PAN ACTION");
 
  for ( int i=0;i<5;i++)
  {
    pointCentre();
    delay(500);
    pointLeft();
    delay(500);
    pointRight();
    delay(500);
    pointCentre();
    
    delay(100);
  }
  
 Serial.println("TESTING TITL 5 TIMES - PLEASE ENSURE THIS IS A TILT ACTION");
 
  for ( int i=0;i<5;i++)
  {
    tiltCentre();
    delay(500);
    tiltUp();
    delay(500);
    tiltDown();
    delay(500);
    tiltCentre();
    
    delay(1000);
  }
 
  
  Serial.println("NOW TESTING OBSTACLE SENSORS FOR 30 SECONDS ");
  Serial.println("TEST SENSOR NOW PLEASE - TILT and PAN SENSOR WILL MOVE");

  startTime = millis();
  endTime = millis();
  
  while(endTime-startTime < 30000)
  {
    
    if ( leftObstacleSensor() == true )
    {
       pointLeft();
       tiltUp();
    }
  
    if ( rightObstacleSensor() == true )
    {
       pointRight();
       tiltDown();
    }
    
    endTime = millis();
    readSensors();  // Best to keep this here
  }
  
  Serial.println("NOW TESTING ULTRASONIC SENSORS FOR 30 SECONDS ");
  Serial.println("TEST SENSOR BY PLACING YOUR HAND OR OBJECT IN FRONT OF ULTRASONIC ( EYES)");
  Serial.println("IF THE DISTANCE IS LESS THAN 90CM IT SHOULD PRINT");

  startTime = millis();
  endTime = millis();
  
  while(endTime-startTime < 30000)
  {

  
    if ( Ultrasonic() < 90 ) {
      Serial.print("Distance is: ");
      Serial.println(Ultrasonic());
    }
    
    endTime = millis();
    readSensors();  // Best to keep this here
  }
  
    pointCentre();
    tiltCentre();
  
  Serial.println("NOW TESTING ULTRASONIC SENSORS FOR 30 SECONDS ");
  Serial.println("TEST SENSOR NOW PLEASE USING BLACK or WHITE for EACH SENSOR");

  startTime = millis();
  endTime = millis();
  
  while(endTime-startTime < 30000)
  {
    
    if ( Left == BLACK ) 
      Serial.println("LEFT SENSOR READS BLACK");
   
   
    if ( Left == WHITE )    
     Serial.println("LEFT SENSOR READS WHITE");
    
    if ( Right == BLACK ) 
      Serial.println("RIGHT SENSOR READS BLACK");
   
   
    if ( Right == WHITE )    
     Serial.println("RIGHT SENSOR READS WHITE");
    
    
    
    
    endTime = millis();
    readSensors();  // Best to keep this here
  }
  
  
    
}
