daverobertson63/RoboticsChallenge/LineFollow/LineFollow.ino

#include"robo.h"
//This LineFollow sketch needs to be completed so the robot follows a BLACK line.
//Use the 2 sensors underneath the robot to decide what to do in each of the 4 possible scenarios.

void loop()
{
   
  if (leftLineSensor() == BLACK && rightLineSensor() == BLACK )
  { 
    //What should I do now?    
    return;    
  }
   
}
