daverobertson63/RoboticsChallenge/Move/Move.ino

#include "robo.h"
//This is a Basic movement sketch, change the code to do whatever you want!
//Start by getting the robot to drive round in a square, a triangle and then a circle.

void loop()
{
    
  forward(1000,255,255);
  
  reverse(1000,255,255);
  
  leftSpin(1000,255); 
  
  rightSpin(1000,255);
    
}
