daverobertson63/RoboticsChallenge/(commit log)

2015-04-13 Updated by simonwilmot to bug fix a couple of "features"
    [Goal.ino, Obstacle.ino, robo.ino]
2016-02-05 Updated pins for new wiring to fix PWM issue.
2016-02-10 First version of interface and test board designs
    MicroBit robot interface board Rev A and Test Board Rev A Eagle files,
    Test Board Arduino config files and test sketch.
    [MicroBit Robot Interface RevA.brd, MicroBit Robot Interface RevA.sch, TestBoardRevA.brd, TestBoardRevA.sch]
2016-02-12 MicroBit interface board documentation
2016-03-14 Updated for production Micro:Bit hardware
    Updated for first production Micro:Bit release (with Button A on Pin 5).
    See https://www.microbit.co.uk/device/pins.
    Updated MicroBit custom library to v0.2.
    Move Button A from pin 4 to pin 5 and swap over P1 and P8 on L3 and L4
    on robot interface board for PWM support.
    Relocate the enable switch to the edge of the board.
    [MicroBit Robot Interface RevB.brd, MicroBit Robot Interface RevB.sch, TestBoardRevB.brd, TestBoardRevB.sch]
2016-03-30 Update to microbit board rev C
    Reorganise the hardware into a single folder. Update the micro:bit
    interface board to Rev C with fix to switch orientation, additional test
    points. Gerbers for OSH Park and SeeedStudio. Update documentation with
    test plan.
    [MicroBit Robot Interface RevA.brd, MicroBit Robot Interface RevA.sch, MicroBit Robot Interface RevB.brd, MicroBit Robot Interface RevB.sch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]
2016-05-10 Production micro:bit interface board
    Documentation updates, wiring diagrams added, board images added. Also
    Gerbers for Arduino shield updated with OSH Park and SeeedStudio
    versions.
    [MicroBit Robot Interface RevC.GBL, MicroBit Robot Interface RevC.GBO, MicroBit Robot Interface RevC.GBP, MicroBit Robot Interface RevC.GBS, MicroBit Robot Interface RevC.GTL, MicroBit Robot Interface RevC.GTO, MicroBit Robot Interface RevC.GTP, MicroBit Robot Interface RevC.GTS]
2016-05-15 Minor board mods
    Increased power traces to 16mil throughout.
    [MicroBit Robot Interface RevD.GBL, MicroBit Robot Interface RevD.GBO, MicroBit Robot Interface RevD.GBP, MicroBit Robot Interface RevD.GBS, MicroBit Robot Interface RevD.GTL, MicroBit Robot Interface RevD.GTO, MicroBit Robot Interface RevD.GTP, MicroBit Robot Interface RevD.GTS]
2016-06-08 Fixed spin functions and other minor bug fixes
    [robo.ino]
